xiongyumail/kicad-lib/pic/SMA-KE.png

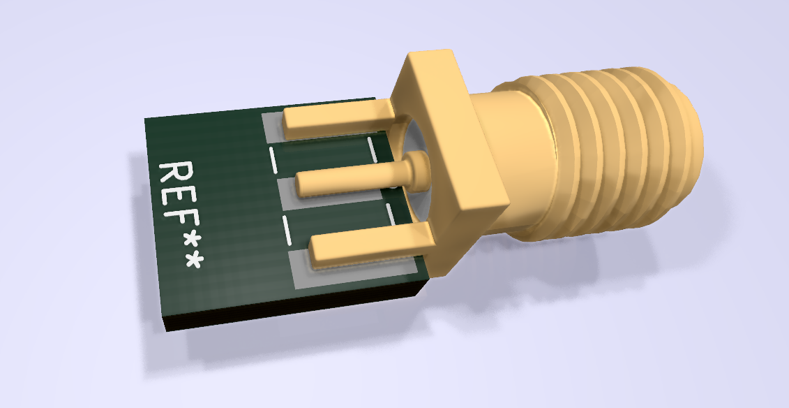
pic/SMA-KE.png
