xiongyumail/kicad-lib/pic/WS2812B-0807.png

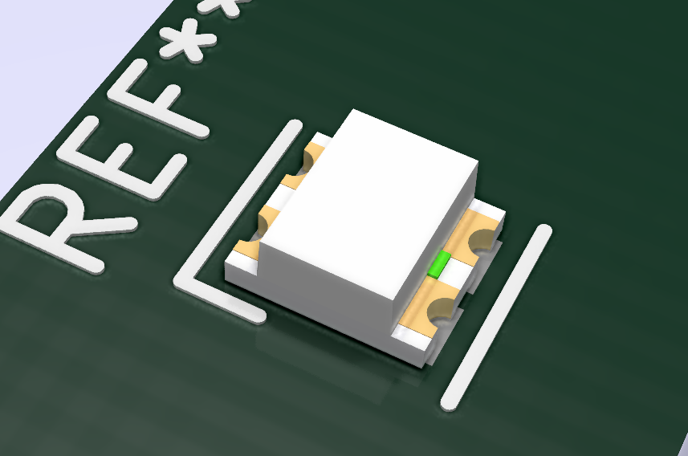
pic/WS2812B-0807.png
