xiongyumail/kicad-lib/README.md

# KICAD-LIB

_Kicad 元器件库_

## library

```bash
cp sym-lib-table ../
```
* 原理图库

## modules

```bash
cp fp-lib-table ../
```

* PCB库

* 3D库
