xiongyumail/kicad-lib/pic/APDS-9960.png

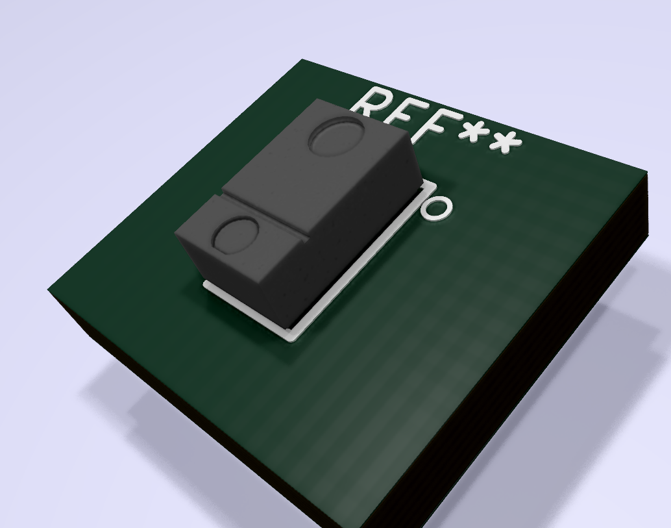
pic/APDS-9960.png
