xiongyumail/kicad-lib/pic/ESP32-WROOM.png

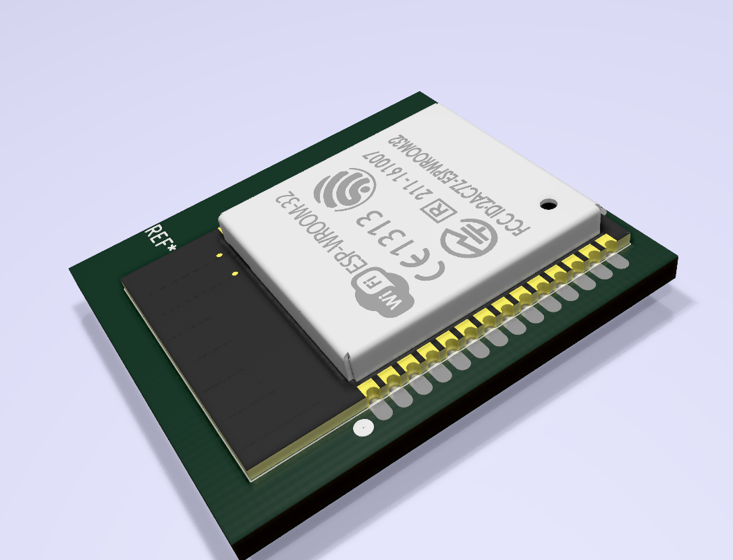
pic/ESP32-WROOM.png
