xiongyumail/kicad-lib/pic/ESP32-WROVER.png

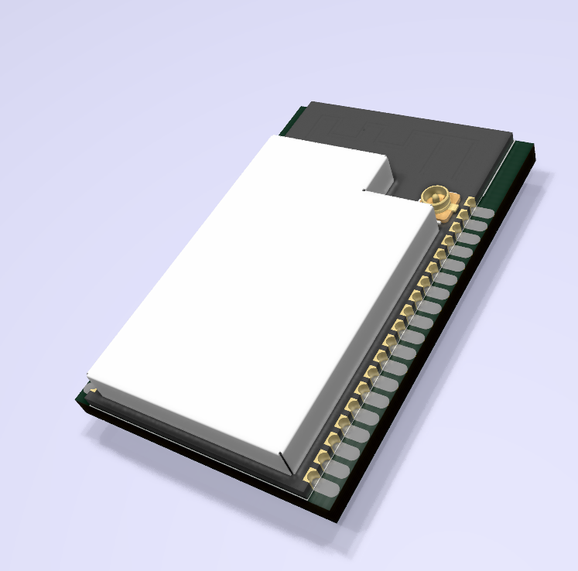
pic/ESP32-WROVER.png
