xiongyumail/kicad-lib/pic/FPC-40.png

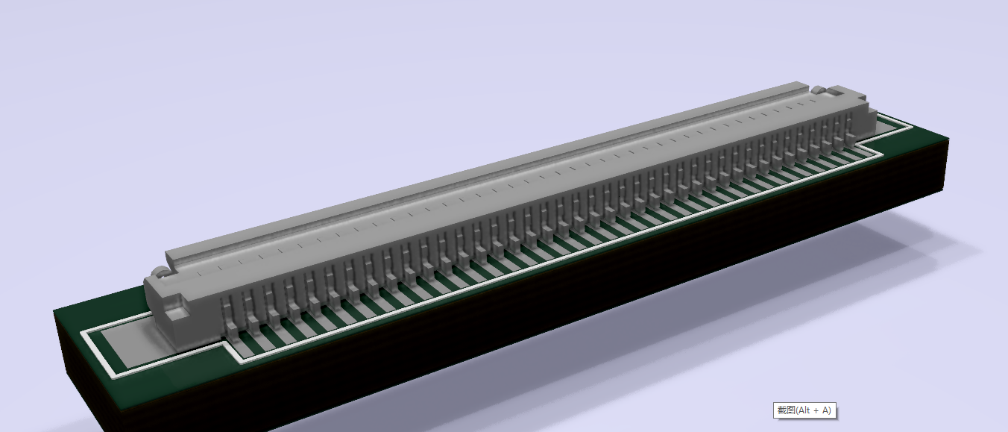
pic/FPC-40.png
