xiongyumail/kicad-lib/pic/IPEX.png

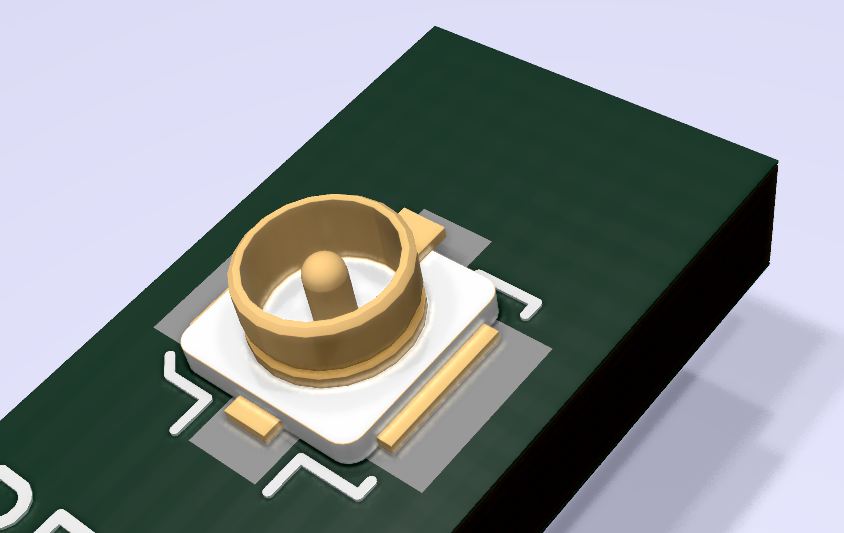
pic/IPEX.png
