xiongyumail/kicad-lib/pic/LCD-0.9.png

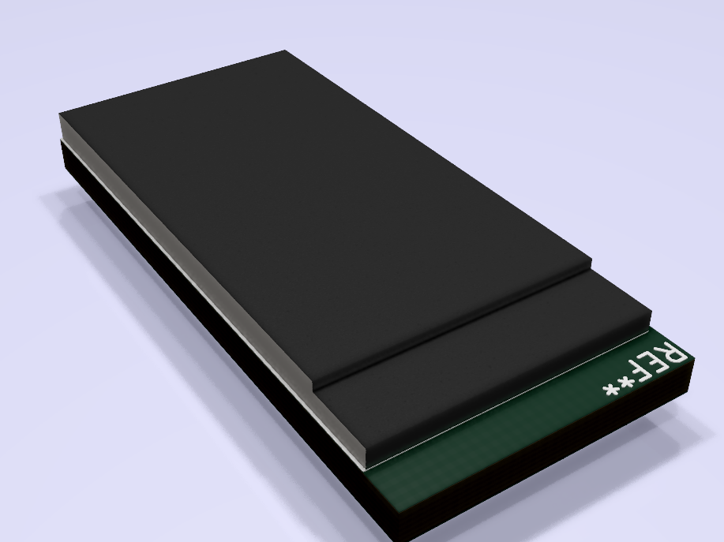
pic/LCD-0.9.png
