xiongyumail/kicad-lib/pic/LCD-1.3.png

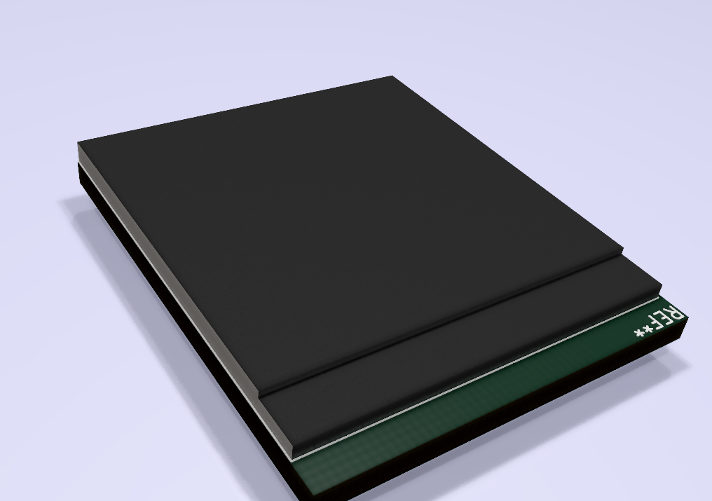
pic/LCD-1.3.png
