xiongyumail/kicad-lib/pic/LCD-1.14.png

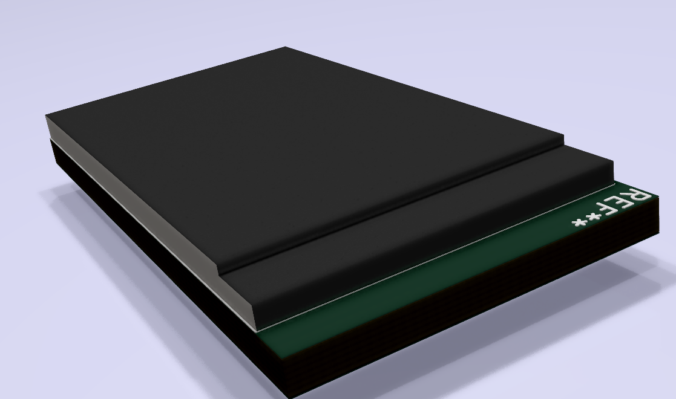
pic/LCD-1.14.png
