xiongyumail/kicad-lib/pic/SMA-KHD.png

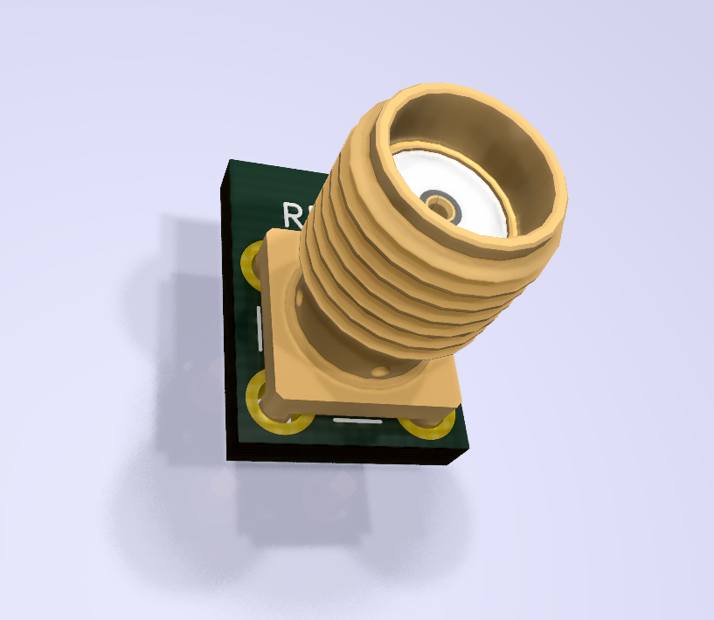
pic/SMA-KHD.png
