xiongyumail/kicad-lib/pic/SMA-KWE.png

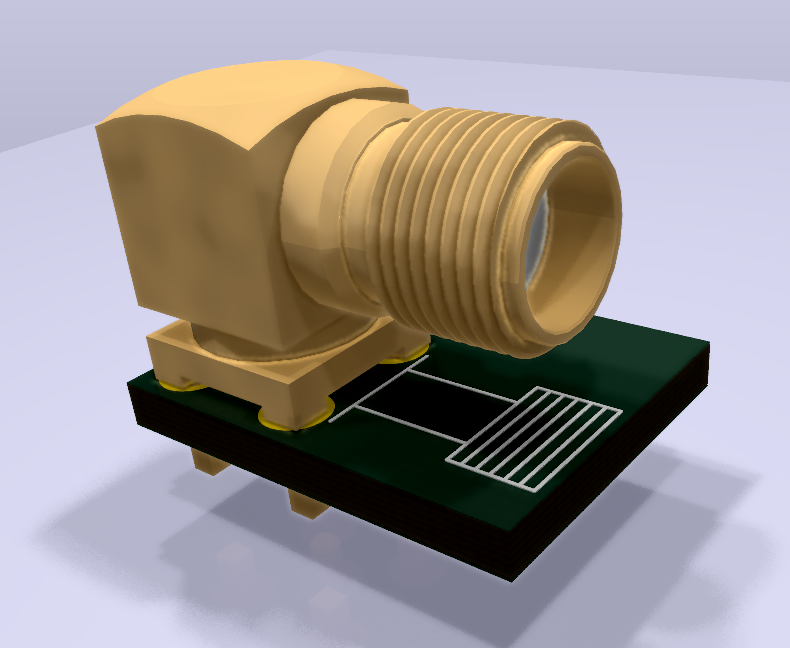
pic/SMA-KWE.png
