xiongyumail/kicad-lib/pic/USB3.1-Typec.png

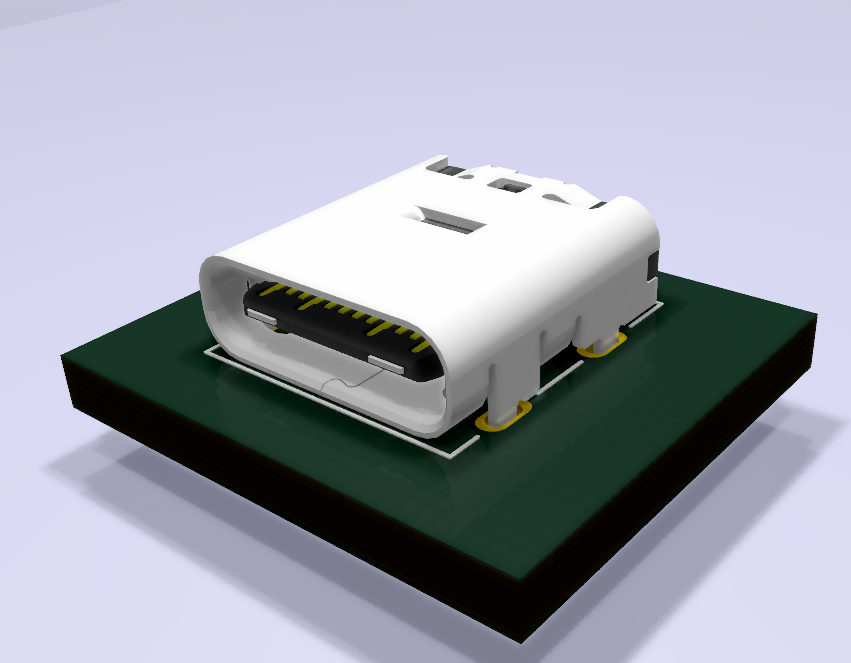
pic/USB3.1-Typec.png
