xiongyumail/kicad-lib/(commit log)

2019-07-24 feature(lib): add kicad lib
2019-07-26 feature(lib): update USB Power dir
2019-09-30 add ESP32-WROVER and APDS-9960 3d model
2020-08-13 add esp32-s2
